Jeremy-Ryan-Mills/hope-project/hope_block_diagram.pdf

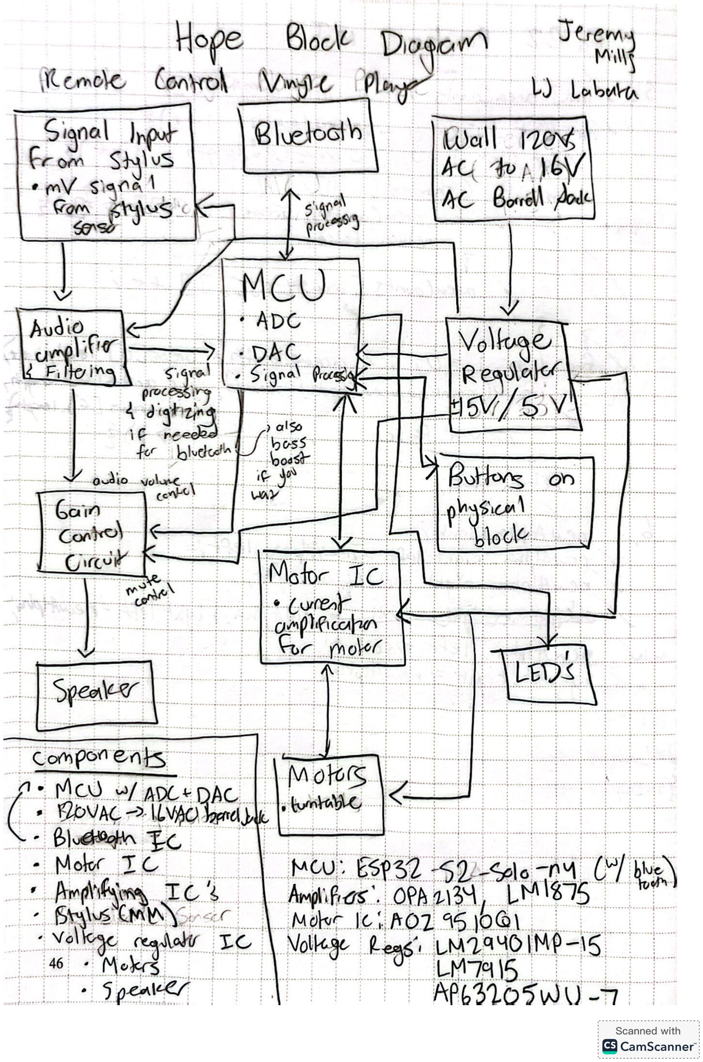
[picture p1: page 1]
