Jeremy-Ryan-Mills/hope-project/61300411121/6130XX11121_61300411121.step

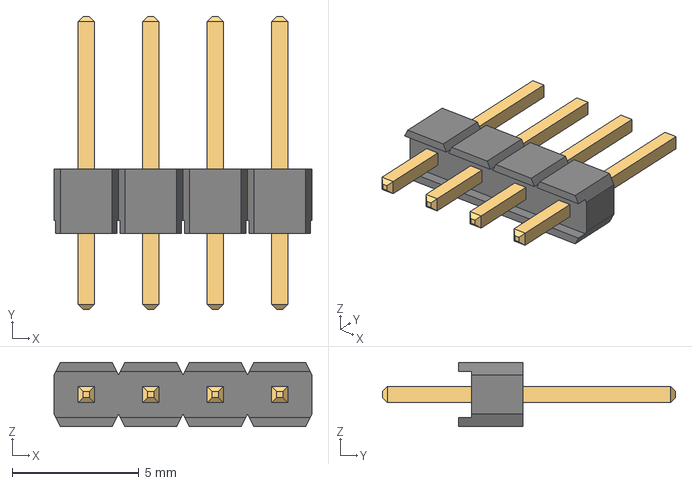
[picture p2: CAD file, 2024-11-08]
61300411121/6130XX11121_61300411121.step
10.2 x 11.5 x 2.54 mm
6130xx11121_PIN x 4
