Jeremy-Ryan-Mills/hope-project/61300511121/6130XX11121_61300511121.step

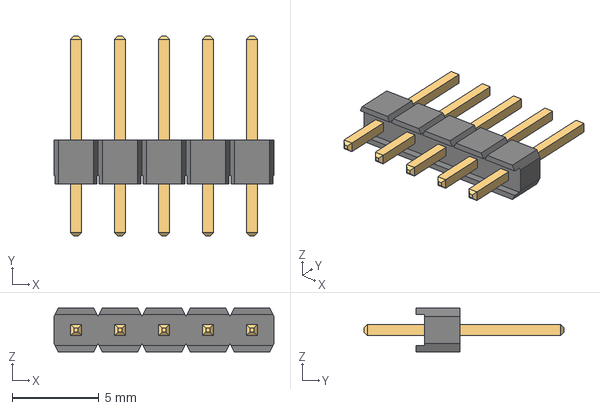
[picture p3: CAD file, 2024-11-08]
61300511121/6130XX11121_61300511121.step
12.7 x 11.5 x 2.54 mm
6130xx11121_PIN x 5
