Jeremy-Ryan-Mills/hope-project/AST_03208MR_R/AST-03208MR-R.step

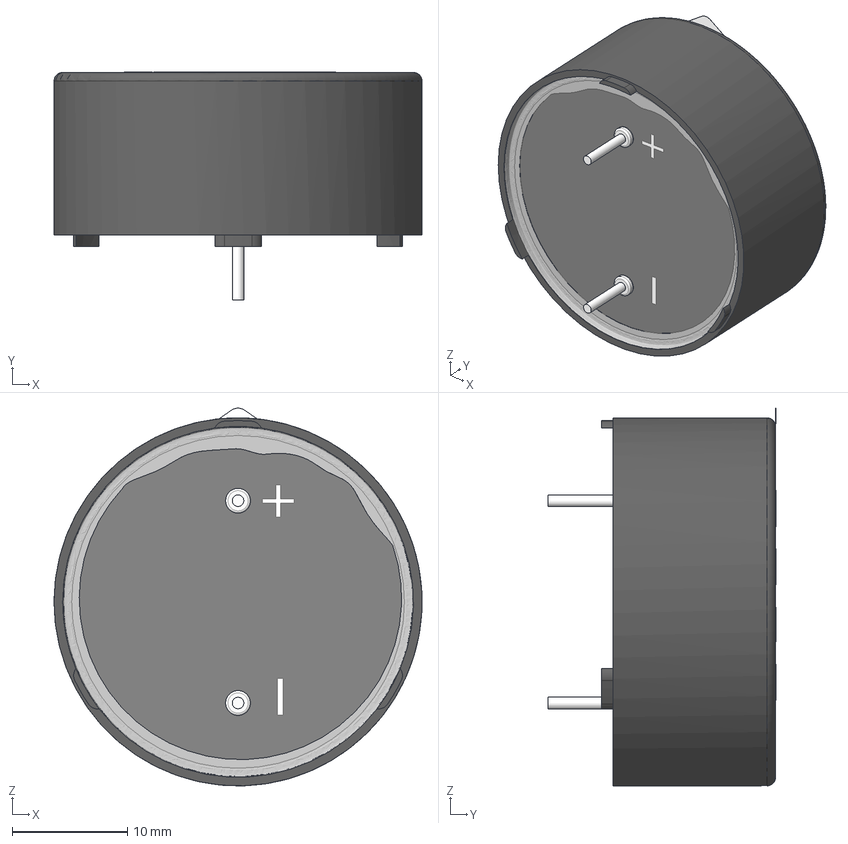
[picture p4: CAD file, 2024-10-26]
AST_03208MR_R/AST-03208MR-R.step
31.9 x 19.7 x 32.7 mm
