Jeremy-Ryan-Mills/hope-project/LT1761ES5_5_TRMPBF/LT1761ES5-5_TRMPBF.step

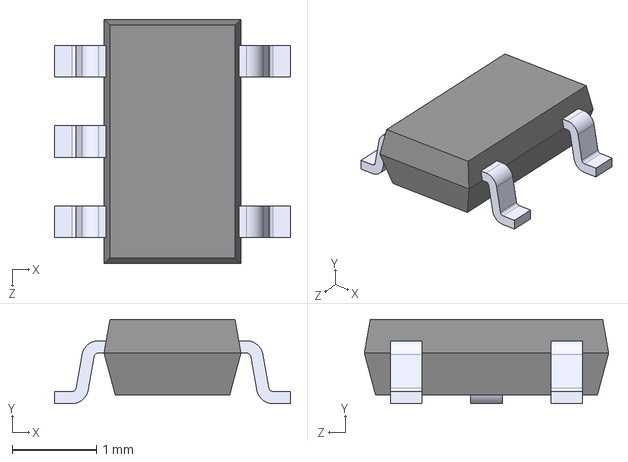
[picture p5: CAD file, 2024-12-07]
LT1761ES5_5_TRMPBF/LT1761ES5-5_TRMPBF.step
2.80 x 1.00 x 2.90 mm
