Jeremy-Ryan-Mills/hope-project/PCM1808PWR/PCM1808PWR.step

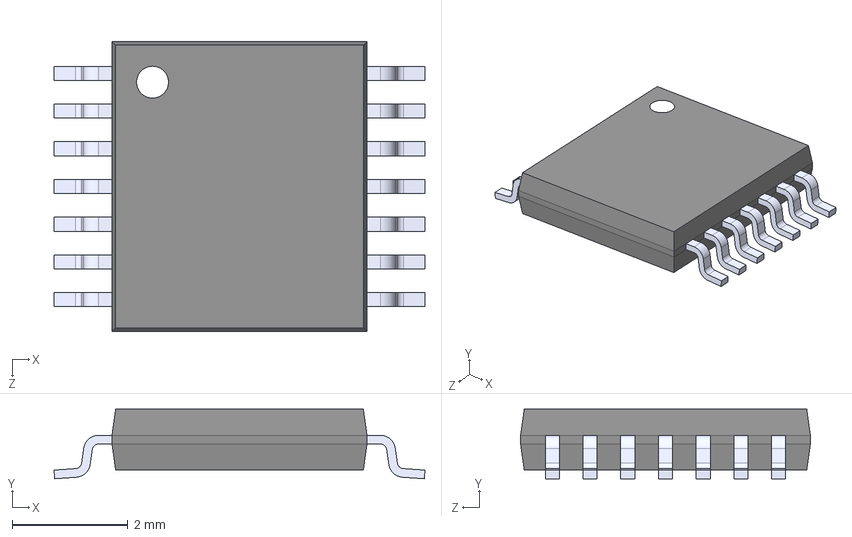
[picture p6: CAD file, 2024-11-08]
PCM1808PWR/PCM1808PWR.step
6.40 x 1.20 x 5.00 mm
