Jeremy-Ryan-Mills/hope-project/PJ_002B/PJ-002B.step

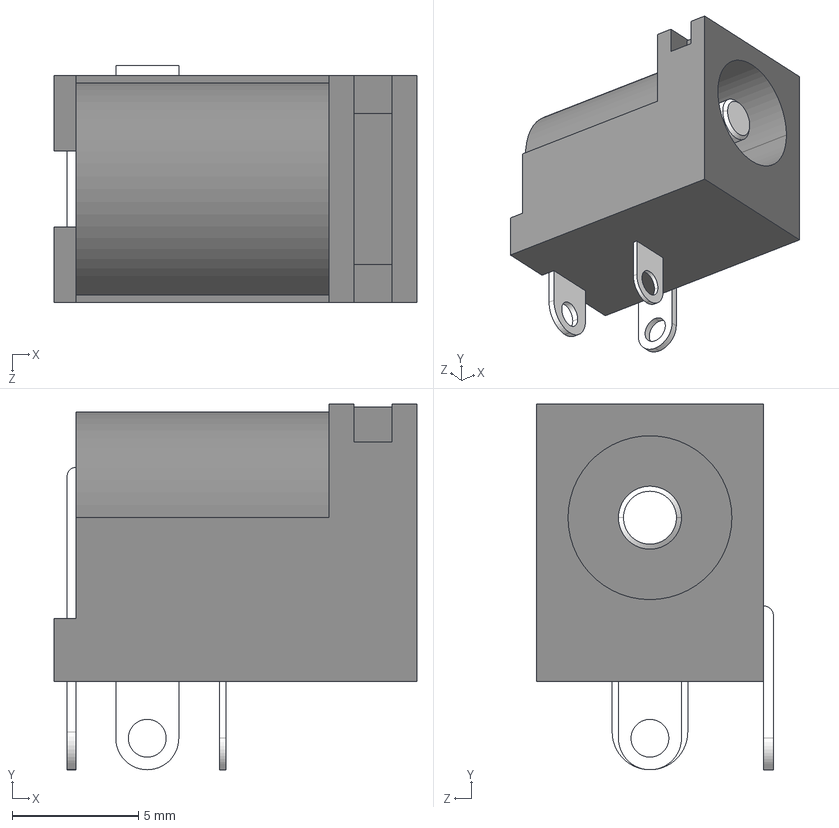
[picture p7: CAD file, 2024-10-26]
PJ_002B/PJ-002B.step
14.4 x 14.5 x 9.40 mm
