Jeremy-Ryan-Mills/hope-project/USB4105_GF_A_120/USB4105GFA120.step

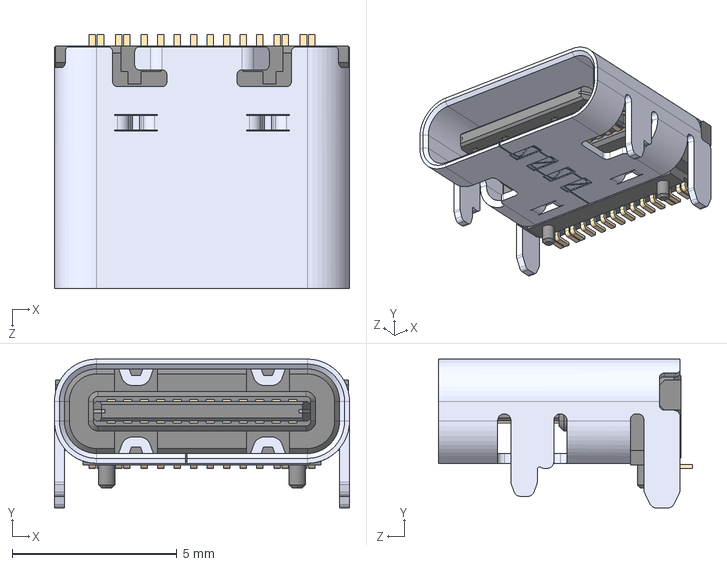
[picture p8: CAD file, 2024-10-31]
USB4105_GF_A_120/USB4105GFA120.step
8.94 x 4.51 x 7.71 mm
