Jeremy-Ryan-Mills/hope-project/schematic_images/hope_final_project.pdf

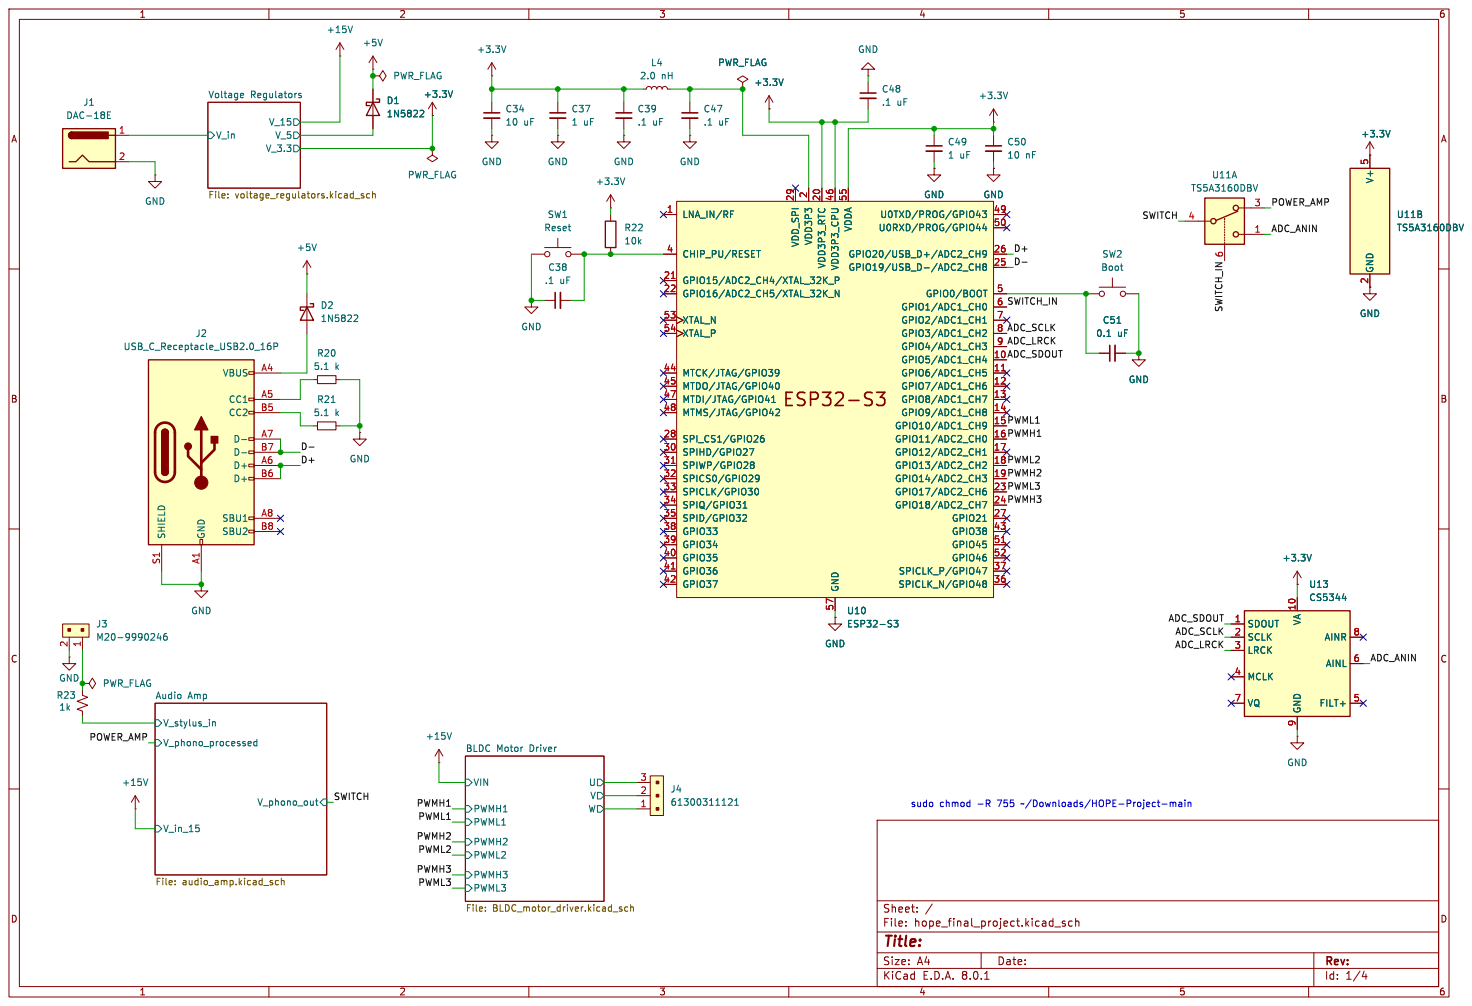
[picture p9: page 1]

2 VDD3P3_RTC 20 GPIO15/ADC2_CH4/XTAL_32K_P 21 GPIO16/ADC2_CH5/XTAL_32K_N 22 GPIO17/ADC2_CH6 23 GPIO18/ADC2_CH7 24 GPIO19/USB_D-/ADC2_CH8 25 GPIO20/USB_D+/ADC2_CH9 26 GPIO21 27 SPI_CS1/GPIO26 28 VDD_SPI 29 SPIHD/GPIO27 30 SPIWP/GPIO28 31 SPICS0/GPIO29 32 SPICLK/GPIO30 33 SPIQ/GPIO31 34 SPID/GPIO32 35 GPIO33 38 GPIO34 39 CHIP_PU/RESET 4 GPIO35 40 GPIO36 41 GPIO37 42 GPIO38 43 MTCK/JTAG/GPIO39 44 MTDO/JTAG/GPIO40 45 VDD3P3_CPU 46 MTDI/JTAG/GPIO41 47 MTMS/JTAG/GPIO42 48 U0TXD/PROG/GPIO43 49 GPIO0/BOOT 5 U0RXD/PROG/GPIO44 50 GPIO45 51 GPIO46 52 XTAL_N 53 XTAL_P 54 VDDA 55 GND 57 GPIO1/ADC1_CH0 6 GPIO2/ADC1_CH1 7 GPIO3/ADC1_CH2 8 GPIO4/ADC1_CH3 9 D1

2 VDD3P3_RTC 20 GPIO15/ADC2_CH4/XTAL_32K_P 21 GPIO16/ADC2_CH5/XTAL_32K_N 22 GPIO17/ADC2_CH6 23 GPIO18/ADC2_CH7 24 GPIO19/USB_D-/ADC2_CH8 25 GPIO20/USB_D+/ADC2_CH9 26 GPIO21 27 SPI_CS1/GPIO26 28 VDD_SPI 29 SPIHD/GPIO27 30 SPIWP/GPIO28 31 SPICS0/GPIO29 32 SPICLK/GPIO30 33 SPIQ/GPIO31 34 SPID/GPIO32 35 GPIO33 38 GPIO34 39 CHIP_PU/RESET 4 GPIO35 40 GPIO36 41 GPIO37 42 GPIO38 43 MTCK/JTAG/GPIO39 44 MTDO/JTAG/GPIO40 45 VDD3P3_CPU 46 MTDI/JTAG/GPIO41 47 MTMS/JTAG/GPIO42 48 U0TXD/PROG/GPIO43 49 GPIO0/BOOT 5 U0RXD/PROG/GPIO44 50 GPIO45 51 GPIO46 52 XTAL_N 53 XTAL_P 54 VDDA 55 GND 57 GPIO1/ADC1_CH0 6 GPIO2/ADC1_CH1 7 GPIO3/ADC1_CH2 8 GPIO4/ADC1_CH3 9 U10 ESP32-S3 GND A1 VBUS A4 CC1 A5 D+ A6 D- A7 SBU1 A8 CC2 B5 D+ B6 D- B7 SBU2 B8 SHIELD S1

BLDC Motor Driver File: BLDC_motor_driver.kicad_sch V_phono_out

Id: 1/4 Title: File: hope_final_project.kicad_sch Sheet: /

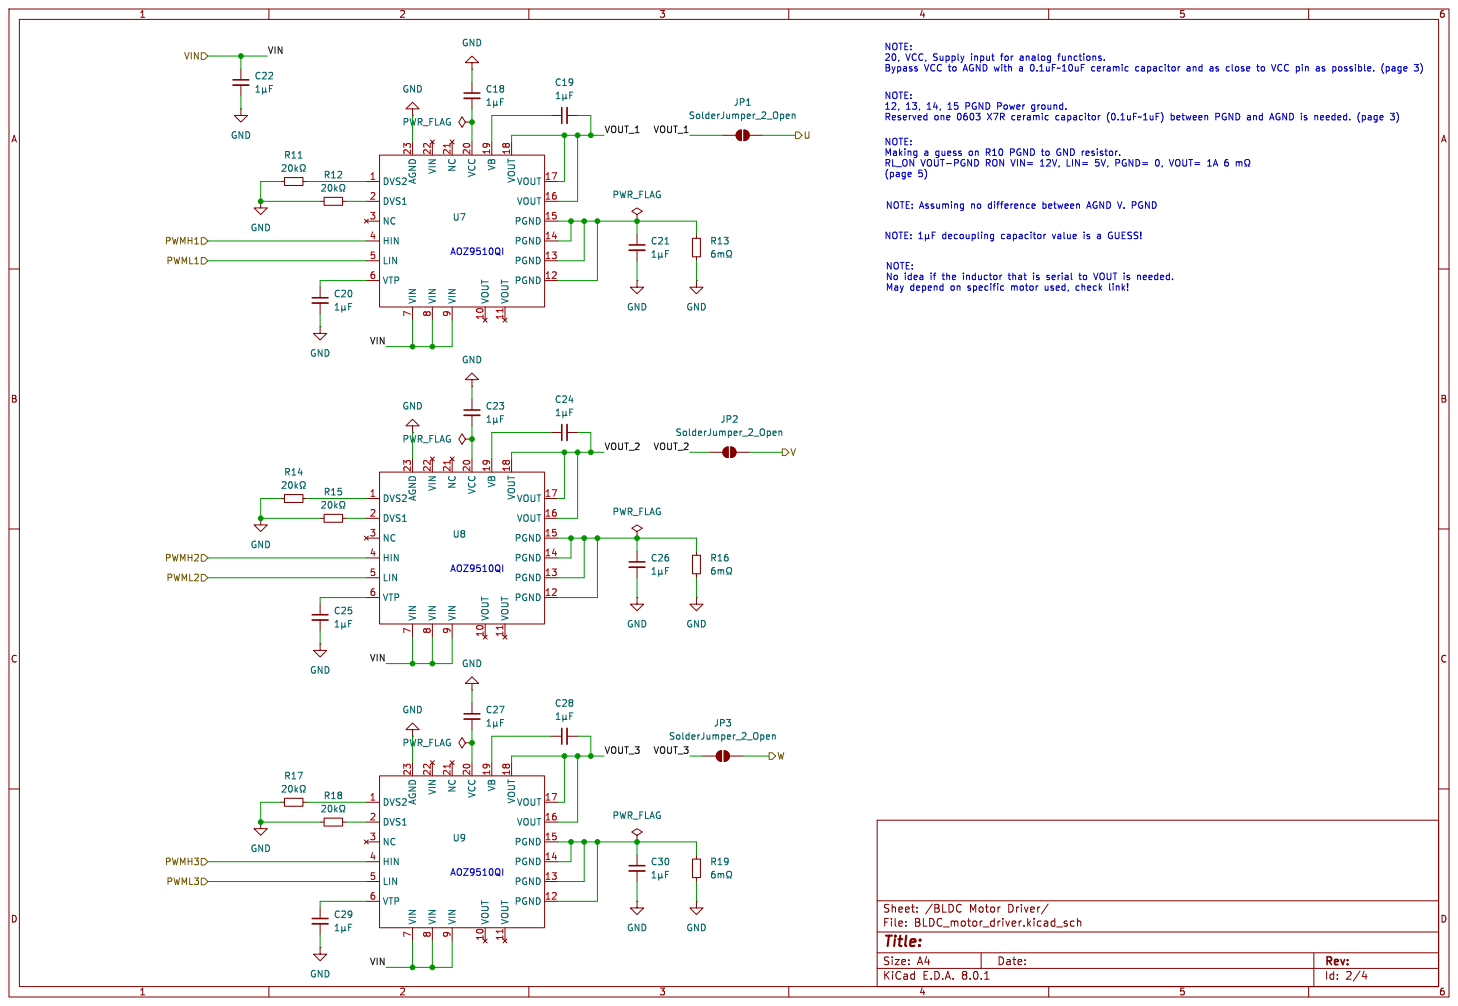
[picture p10: page 2]

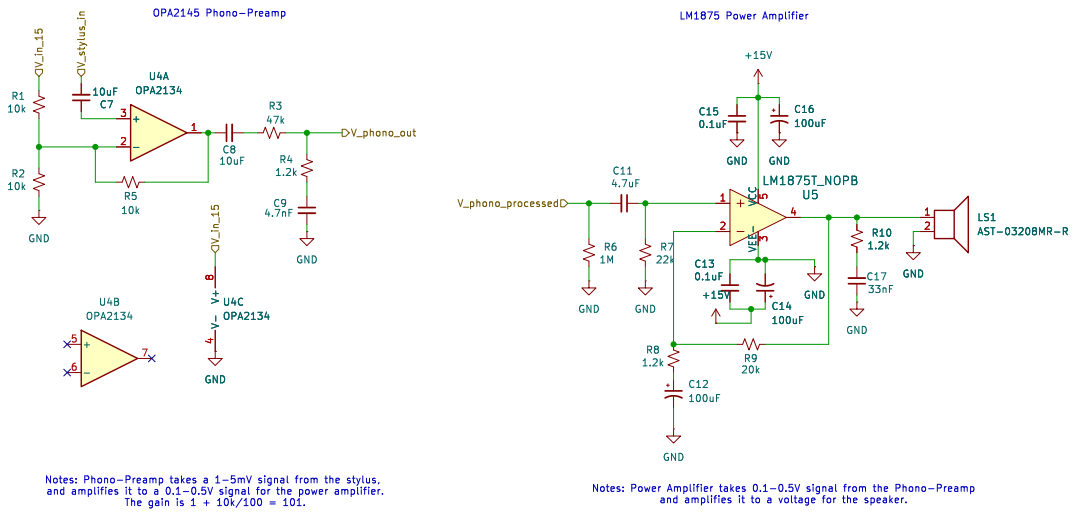
[picture p11: page 3]

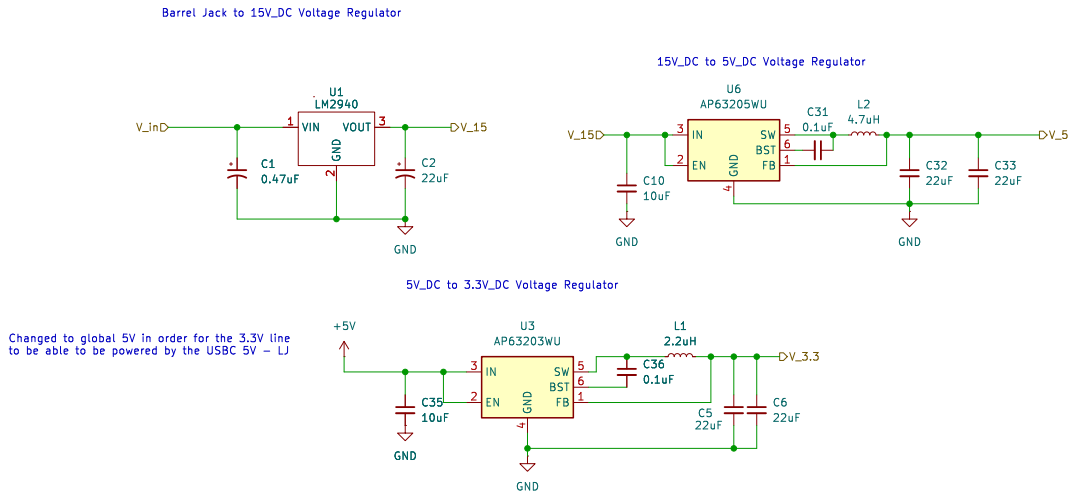
[picture p12: page 4]

Changed to global 5V in order for the 3.3V line
