Jeremy-Ryan-Mills/hope-project/recordplayer_hope_final_project_bom.pdf

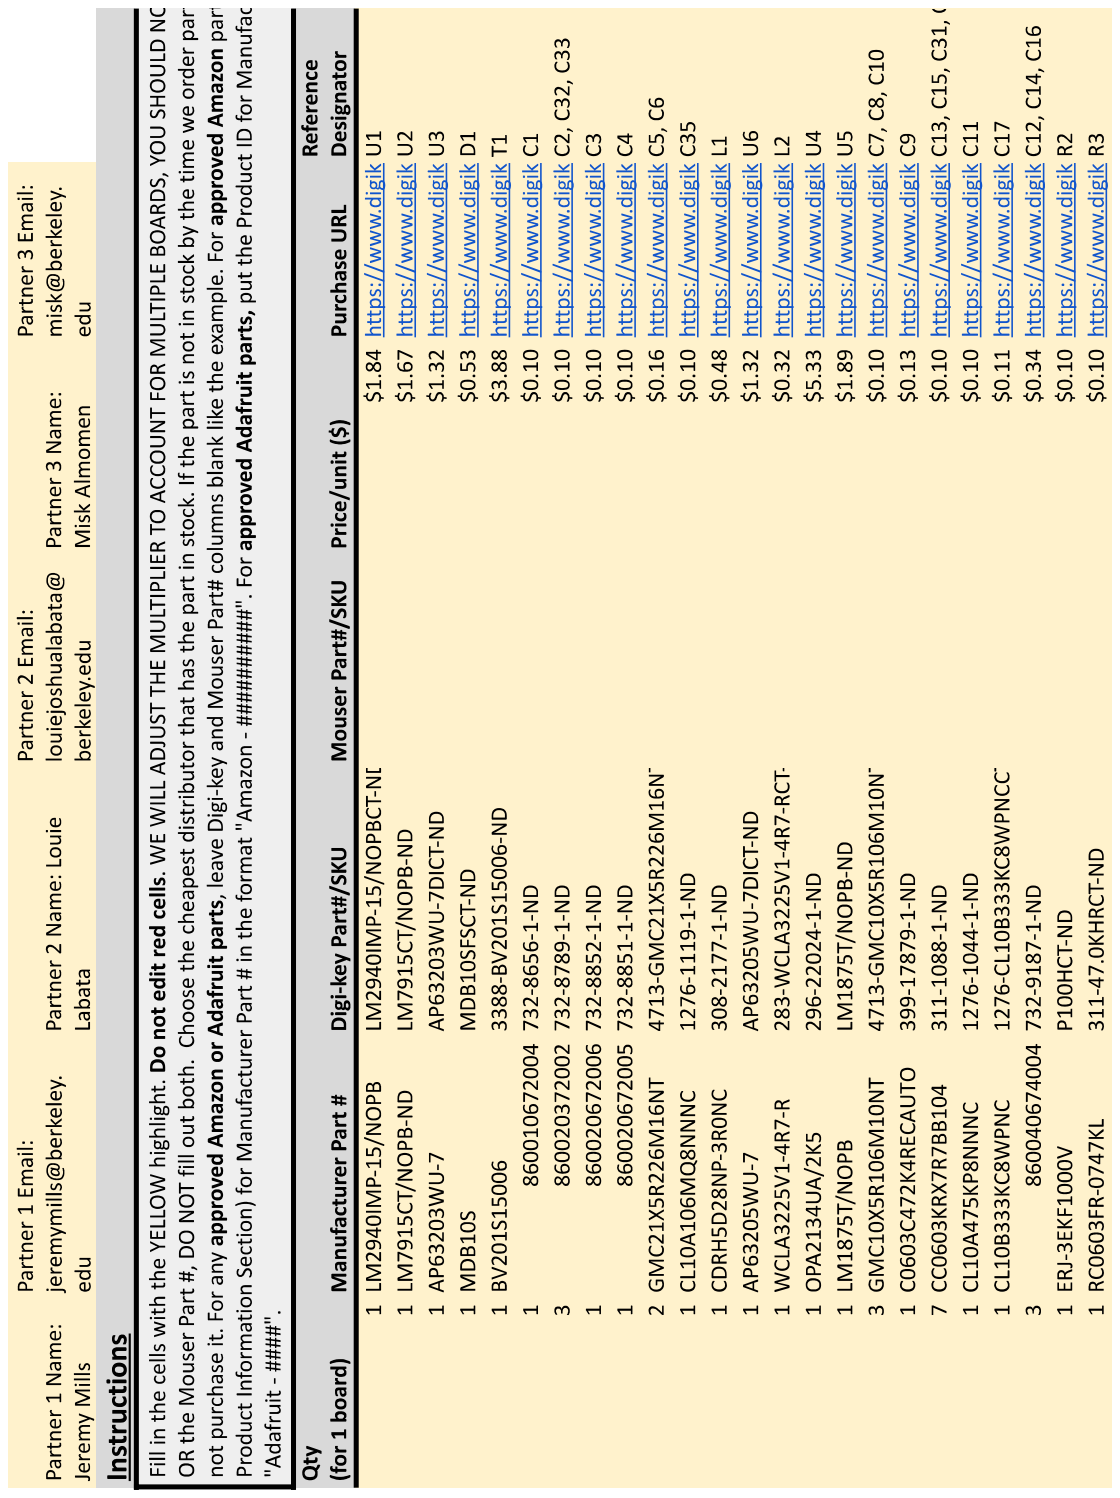
[picture p13: page 1]

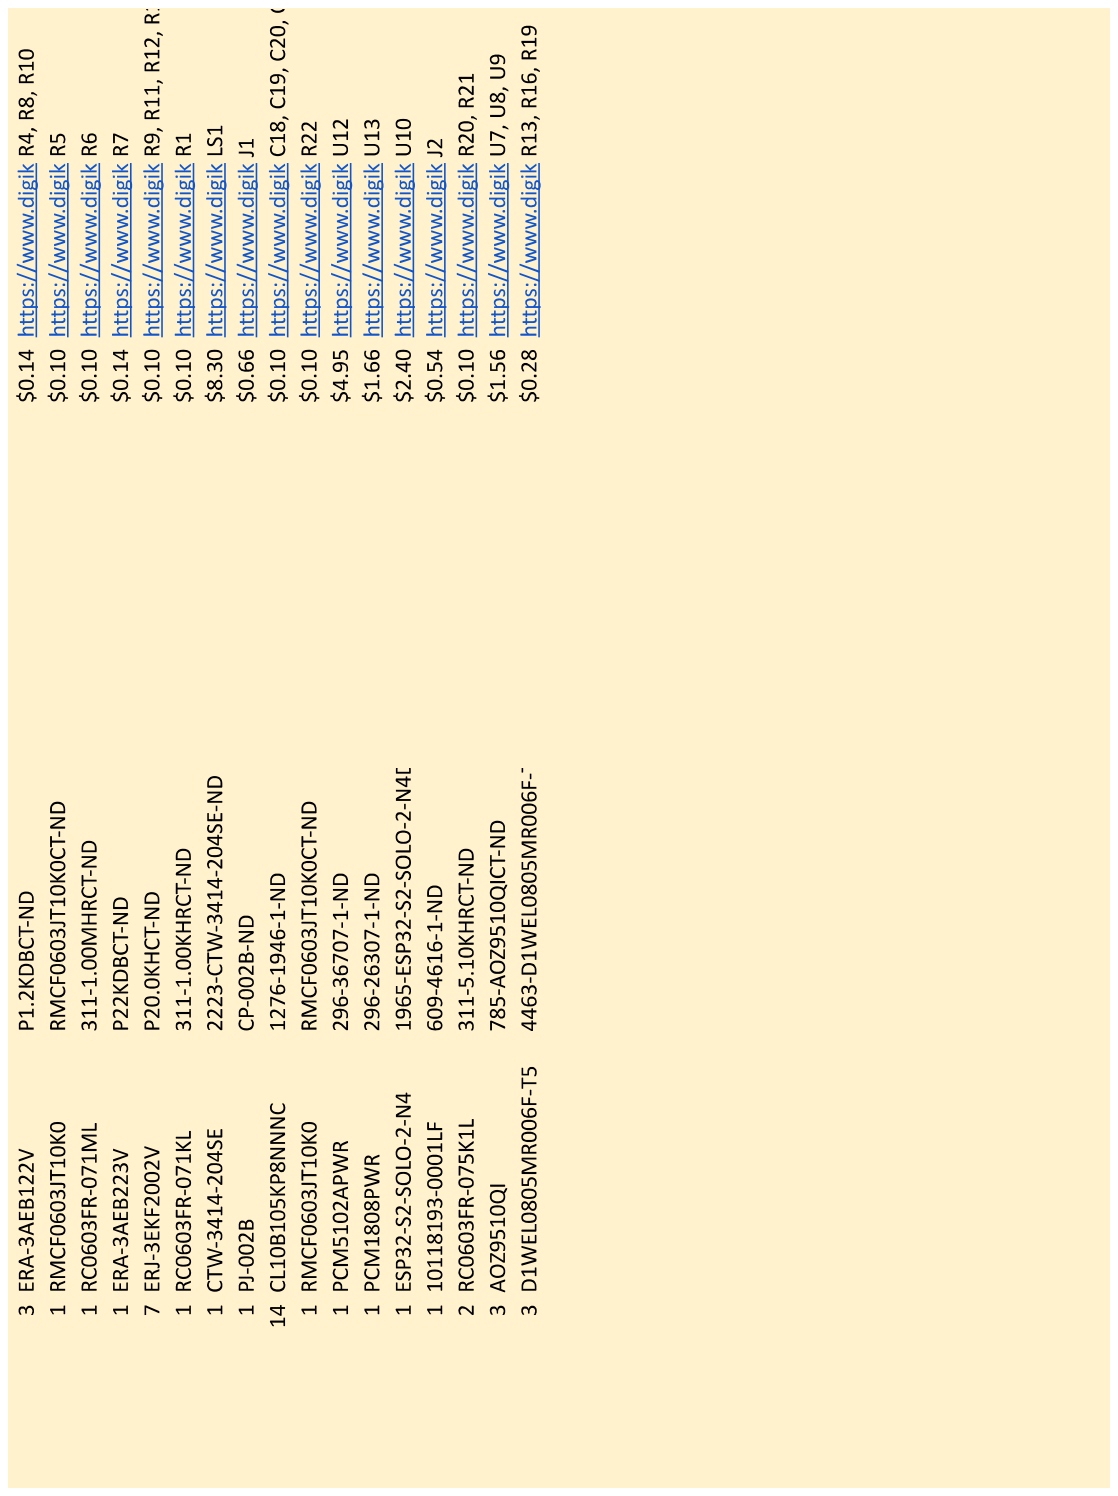
[picture p14: page 2]
