Jeremy-Ryan-Mills/hope-project/hope_final_project.kicad_pcb

## KiCad design hope_final_project.kicad_pcb (2024-12-07)

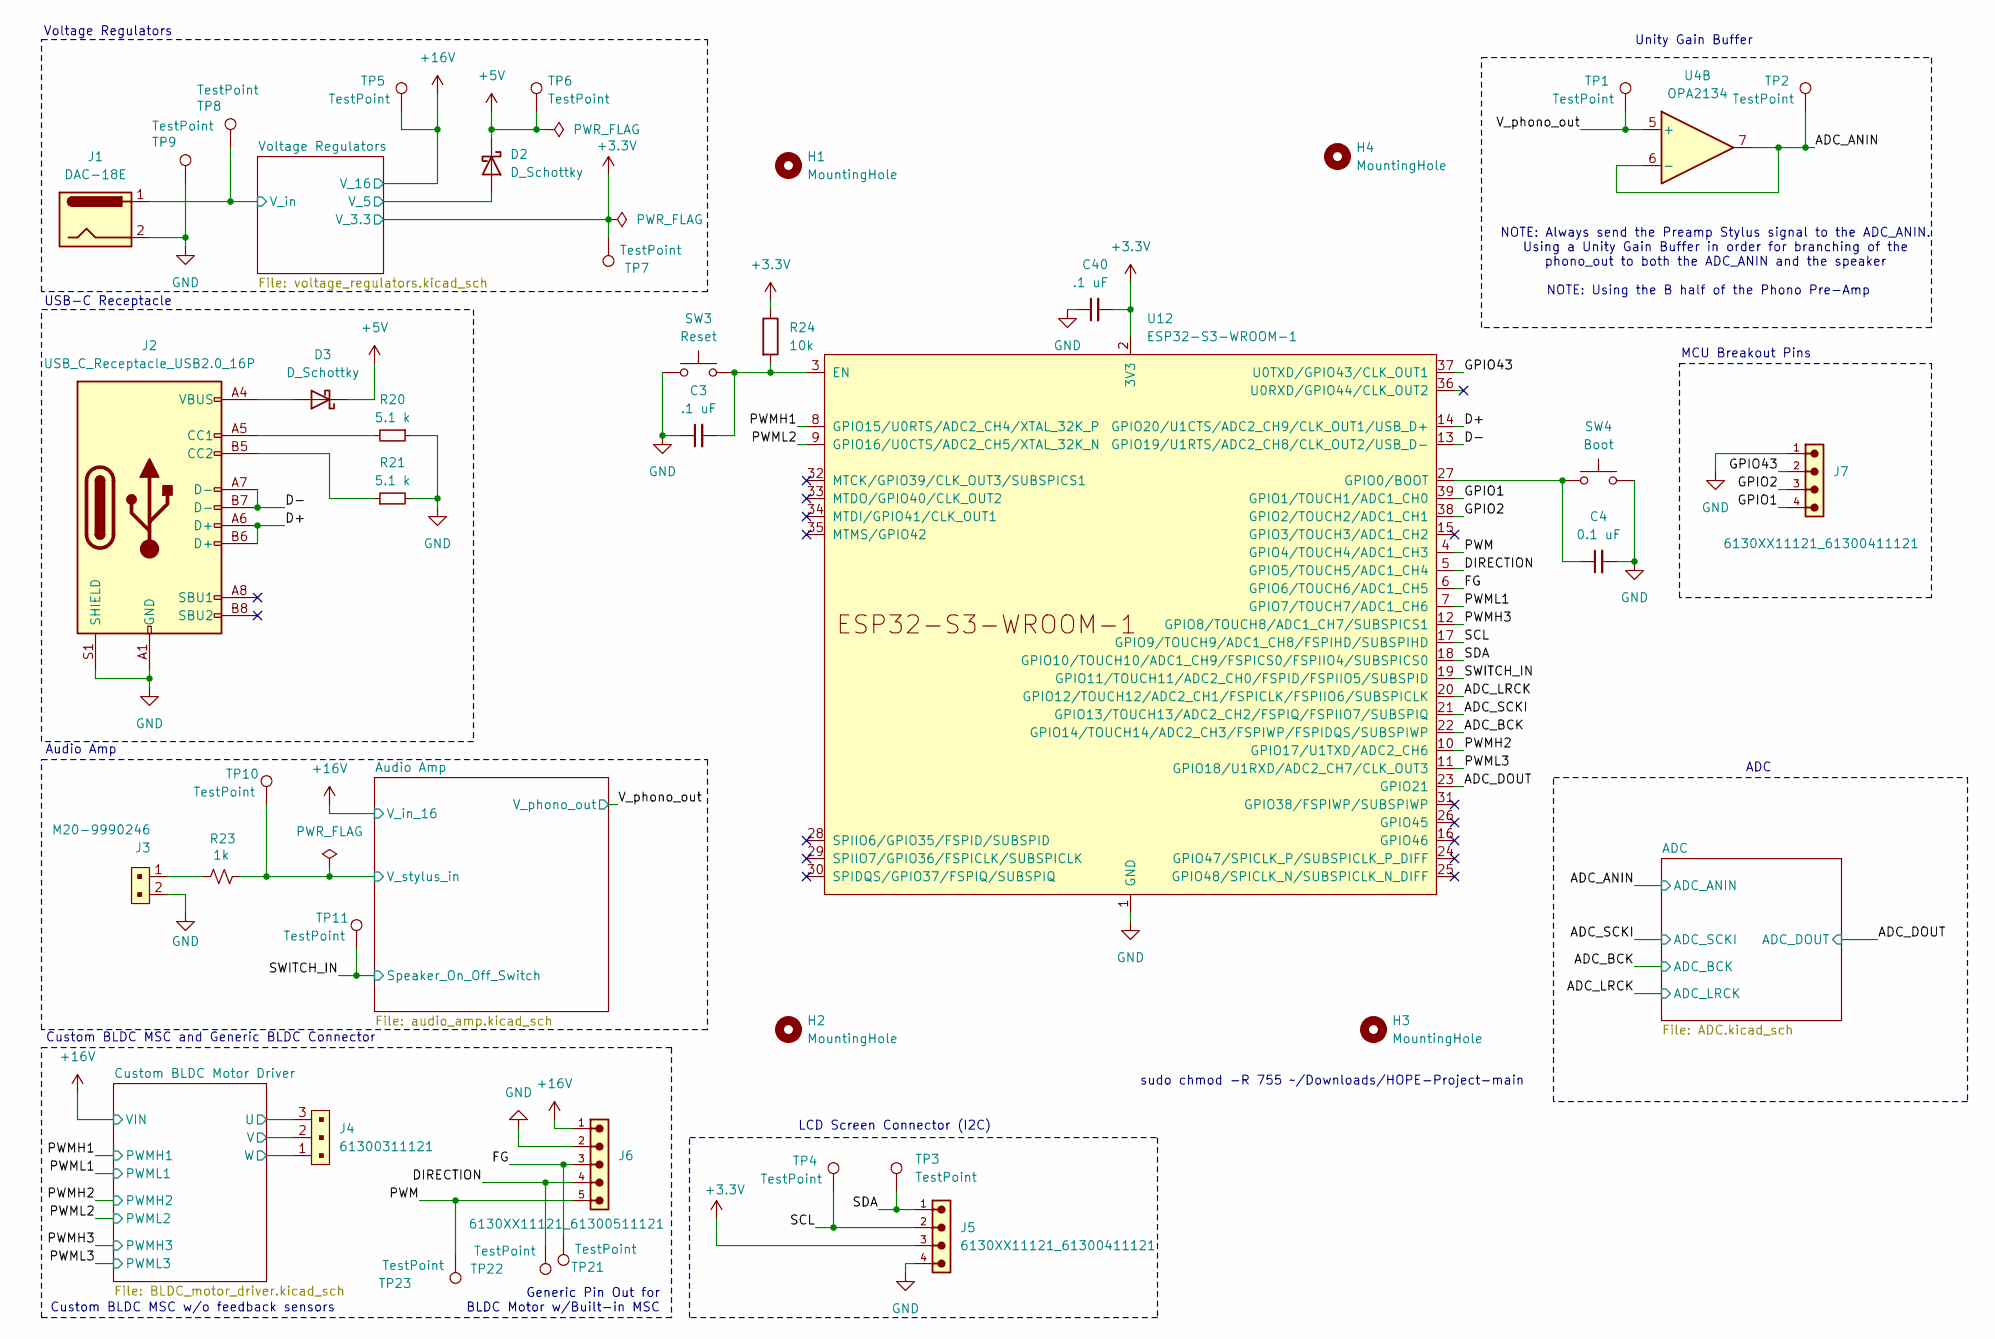
[picture p15: schematic hope_final_project.kicad_sch]

Parts:
C3, C40: .1 uF; C_0805_2012Metric
C4: 0.1 uF; C_0805_2012Metric
D2, D3: D_Schottky; D_SOD-123F
H1, H2, H3, H4: MountingHole; MountingHole_3.2mm_M3
J1: DAC-18E; PJ_002B
J2: USB_C_Receptacle_USB2.0_16P; GCT_USB4105GFA120
J3: M20-9990246; PinHeader_1x2_P2.54mm; MPN M20-9990246; Digi-Key_PN 952-2262-ND
J4: 61300311121; PinHeader_1x3_P2.54_Drill1.1mm; MPN 61300311121; Digi-Key_PN 732-5316-ND
J5, J7: 6130XX11121_61300411121; 61300411121; PART-NUMBER 61300411121
J6: 6130XX11121_61300511121; 61300511121; PART-NUMBER 61300511121
R20, R21: 5.1 k; R_0805_2012Metric
R23: 1k; R_0805_2012Metric
R24: 10k; R_0805_2012Metric
SW3: Reset; TL3301_A_G_EWI
SW4: Boot; TL3301_A_G_EWI
TP1, TP2, TP3, TP4, TP5, TP6, TP7, TP8, TP9, TP10, TP11, TP21, TP22, TP23: TestPoint; TestPoint_Pad_1.5x1.5mm
U4: OPA2134; SOIC-8_W3.9mm
U12: ESP32-S3-WROOM-1

Connections:
+3.3V: C40.2, J5.3, R24.1, TP7.1, U12.2 (3V3); also elsewhere on the board
+5V: D2.1 (K), D3.1 (K), TP6.1; also elsewhere on the board
+16V: J6.1, TP5.1; also elsewhere on the board
/ADC_ANIN: TP2.1, U4.6 (-), U4.7; also elsewhere on the board
/ADC_BCK: U12.22 (GPIO14/TOUCH14/ADC2_CH3/FSPIWP/FSPIDQS/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); also elsewhere on the board
/ADC_DOUT: U12.23 (GPIO21); also elsewhere on the board
/ADC_LRCK: U12.20 (GPIO12/TOUCH12/ADC2_CH1/FSPICLK/FSPIIO6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); also elsewhere on the board
/ADC_SCKI: U12.21 (GPIO13/TOUCH13/ADC2_CH2/FSPIQ/FSPIIO7/S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); also elsewhere on the board
/Audio Amp/V_stylus_in: R23.1, TP10.1; also elsewhere on the board
/Custom BLDC Motor Driver/VOUT_1: J4.3; also elsewhere on the board
/Custom BLDC Motor Driver/VOUT_2: J4.2; also elsewhere on the board
/Custom BLDC Motor Driver/VOUT_3: J4.1; also elsewhere on the board
/D+: J2.A6 (D+), J2.B6 (D+), U12.14 (GPIO20/U1CTS/ADC2_CH9/CLK_OUT1/USB_D+)
/D-: J2.A7 (D-), J2.B7 (D-), U12.13 (GPIO19/U1RTS/ADC2_CH8/CLK_OUT2/USB_D-)
/DIRECTION: J6.4, TP22.1, U12.5 (GPIO5/TOUCH5/ADC1_CH4)
/FG: J6.3, TP21.1, U12.6 (GPIO6/TOUCH6/ADC1_CH5)
/GPIO1: J7.4, U12.39 (GPIO1/TOUCH1/ADC1_CH0)
/GPIO2: J7.3, U12.38 (GPIO2/TOUCH2/ADC1_CH1)
/GPIO43: J7.2, U12.37 (U0TXD/GPIO43/CLK_OUT1)
/PWM: J6.5, TP23.1, U12.4 (GPIO4/TOUCH4/ADC1_CH3)
/PWMH1: U12.8 (GPIO15/U0RTS/ADC2_CH4/XTAL_32K_P); also elsewhere on the board
/PWMH2: U12.10 (GPIO17/U1TXD/ADC2_CH6); also elsewhere on the board
/PWMH3: U12.12 (GPIO8/TOUCH8/ADC1_CH7/SUBSPICS1); also elsewhere on the board
/PWML1: U12.7 (GPIO7/TOUCH7/ADC1_CH6); also elsewhere on the board
/PWML2: U12.9 (GPIO16/U0CTS/ADC2_CH5/XTAL_32K_N); also elsewhere on the board
/PWML3: U12.11 (GPIO18/U1RXD/ADC2_CH7/CLK_OUT3); also elsewhere on the board
/SCL: J5.2, TP4.1, U12.17 (GPIO9/TOUCH9/ADC1_CH8/FSPIHD/SUBSPIHD)
/SDA: J5.1, TP3.1, U12.18 (GPIO10/TOUCH10/ADC1_CH9/FSPICS0/FSPIIO4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)
/SWITCH_IN: TP11.1, U12.19 (GPIO11/TOUCH11/ADC2_CH0/FSPID/FSPIIO5/S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); also elsewhere on the board
/V_phono_out: TP1.1, U4.5 (+); also elsewhere on the board
/Voltage Regulators/V_5: D2.2 (A); also elsewhere on the board
/Voltage Regulators/V_in: J1.1, TP8.1; also elsewhere on the board
GND: C3.1, C4.2, C40.1, J1.2, J2.A1 (GND), J2.A12 (GND), J2.B1 (GND), J2.B12 (GND), J2.S1 (SHIELD), J3.2, J5.4, J6.2, J7.1, R20.1, R21.2, SW3.1 (A), SW3.2 (A), SW4.3 (B), SW4.4 (B), TP9.1, U12.1 (GND), U12.40 (GND), U12.41 (GND); also elsewhere on the board
unnamed: D3.2 (A), J2.A4 (VBUS), J2.A9 (VBUS), J2.B4 (VBUS), J2.B9 (VBUS)
unnamed: J2.A5 (CC1), R20.2
unnamed: J2.B5 (CC2), R21.1
unnamed: J3.1, R23.2
unnamed: C3.2, R24.2, SW3.3 (B), SW3.4 (B), U12.3 (EN)
unnamed: C4.1, SW4.1 (A), SW4.2 (A), U12.27 (GPIO0/BOOT)

Notes on the sheet:
Custom BLDC MSC w/o feedback sensors
Audio Amp
Unity Gain Buffer
MCU Breakout Pins
NOTE: Using the B half of the Phono Pre-Amp
USB-C Receptacle
LCD Screen Connector (I2C)
Custom BLDC MSC and Generic BLDC Connector
Generic Pin Out for BLDC Motor w/Built-in MSC
ADC
Voltage Regulators
NOTE: Always send the Preamp Stylus signal to the ADC_ANIN. Using a Unity Gain Buffer in order for branching of the phono_out to both the ADC_ANIN and the speaker
sudo chmod -R 755 ~/Downloads/HOPE-Project-main

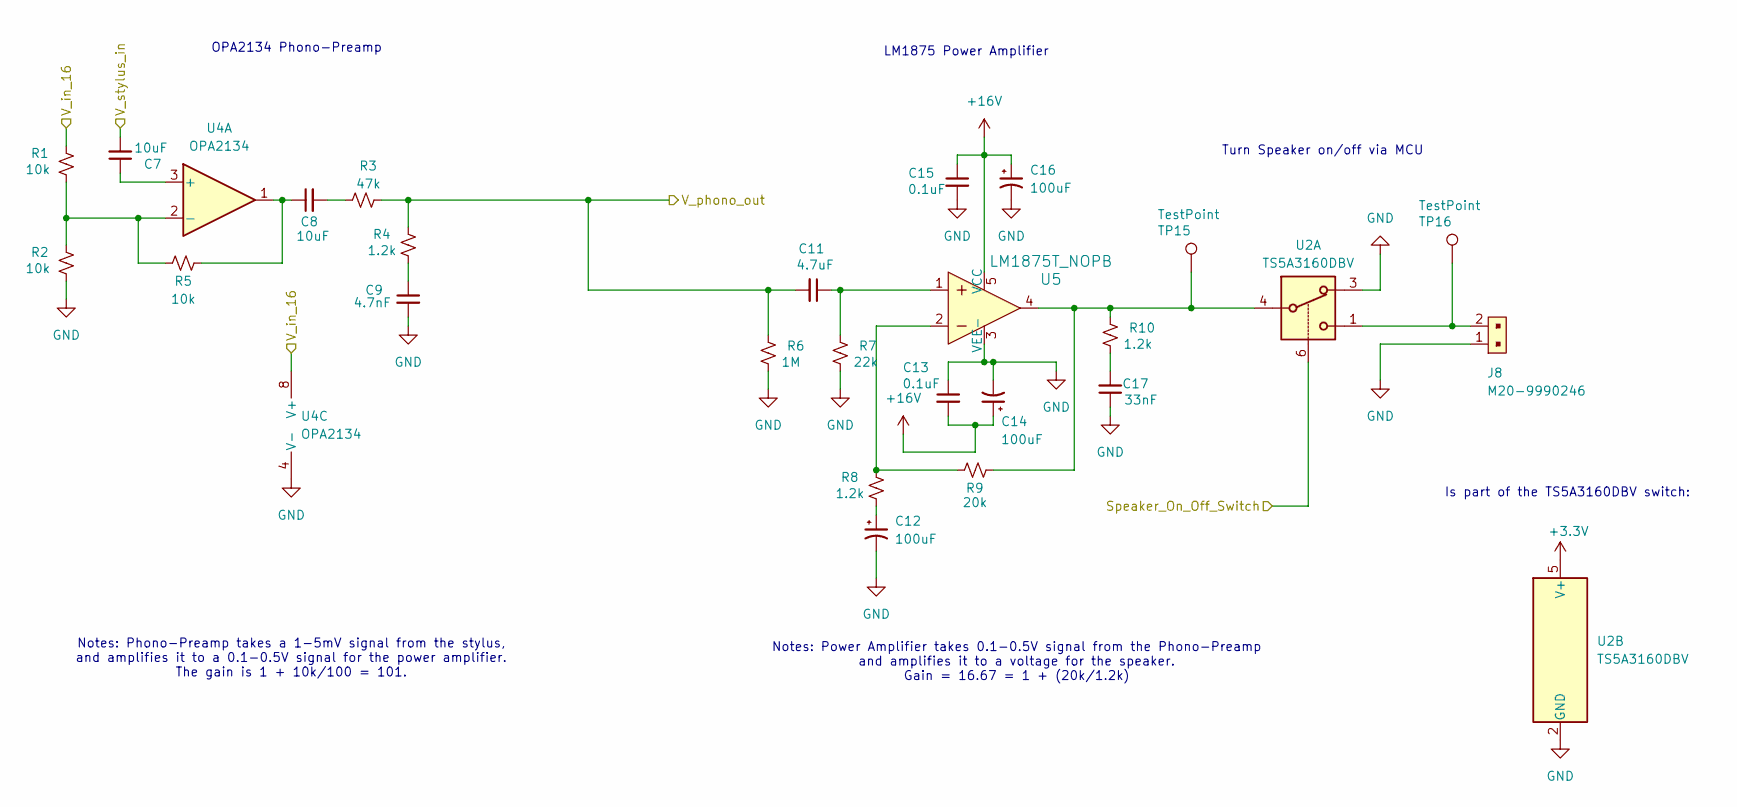
[picture p16: schematic audio_amp.kicad_sch]

Parts:
C7, C8: 10uF; C_0805_2012Metric
C9: 4.7nF; C_0805_2012Metric
C11: 4.7uF; C_0805_2012Metric
C12, C14, C16: 100uF; C_Radial_D8.0mm_H11.5mm_P3.50mm
C13, C15: 0.1uF; C_0805_2012Metric
C17: 33nF; C_0805_2012Metric
J8: M20-9990246; PinHeader_1x2_P2.54mm; MPN M20-9990246; Digi-Key_PN 952-2262-ND
R1, R2, R5: 10k; R_0805_2012Metric
R3: 47k; R_0805_2012Metric
R4, R8, R10: 1.2k; R_0805_2012Metric
R6: 1M; R_0805_2012Metric
R7: 22k; R_0805_2012Metric
R9: 20k; R_0805_2012Metric
TP15, TP16: TestPoint; TestPoint_Pad_1.5x1.5mm
U2: TS5A3160DBV; SOT-23-6
U4: OPA2134; SOIC-8_W3.9mm
U5: LM1875T_NOPB; TO-220-5; MPN LM1875T/NOPB; Digi-Key_PN LM1875T/NOPB-ND

Connections:
+3.3V: U2.5 (V+); also elsewhere on the board
+16V: C13.2, C14.1, C15.1, C16.1, R1.1, U4.8 (V+), U5.5 (VCC); also elsewhere on the board
/Audio Amp/V_stylus_in: C7.2; also elsewhere on the board
/SWITCH_IN: U2.6; also elsewhere on the board
/V_phono_out: C11.2, R3.2, R4.1, R6.1; also elsewhere on the board
GND: C9.2, C12.2, C13.1, C14.2, C15.2, C16.2, C17.1, J8.1, R2.2, R6.2, R7.2, U2.2 (GND), U2.3, U4.4 (V-), U5.3 (VEE-); also elsewhere on the board
unnamed: C8.1, R5.2, U4.1
unnamed: C8.2, R3.1
unnamed: C9.1, R4.2
unnamed: C11.1, R7.1, U5.1
unnamed: C12.1, R8.2
unnamed: C17.2, R10.2
unnamed: J8.2, TP16.1, U2.1
unnamed: R8.1, R9.1, U5.2
unnamed: R9.2, R10.1, TP15.1, U2.4, U5.4
unnamed: C7.1, U4.3 (+)
unnamed: R1.2, R2.1, R5.1, U4.2 (-)

Notes on the sheet:
OPA2134 Phono-Preamp
Is part of the TS5A3160DBV switch:
LM1875 Power Amplifier
Notes: Phono-Preamp takes a 1-5mV signal from the stylus, and amplifies it to a 0.1-0.5V signal for the power amplifier. The gain is 1 + 10k/100 = 101.
Notes: Power Amplifier takes 0.1-0.5V signal from the Phono-Preamp and amplifies it to a voltage for the speaker. Gain = 16.67 = 1 + (20k/1.2k)
Turn Speaker on/off via MCU

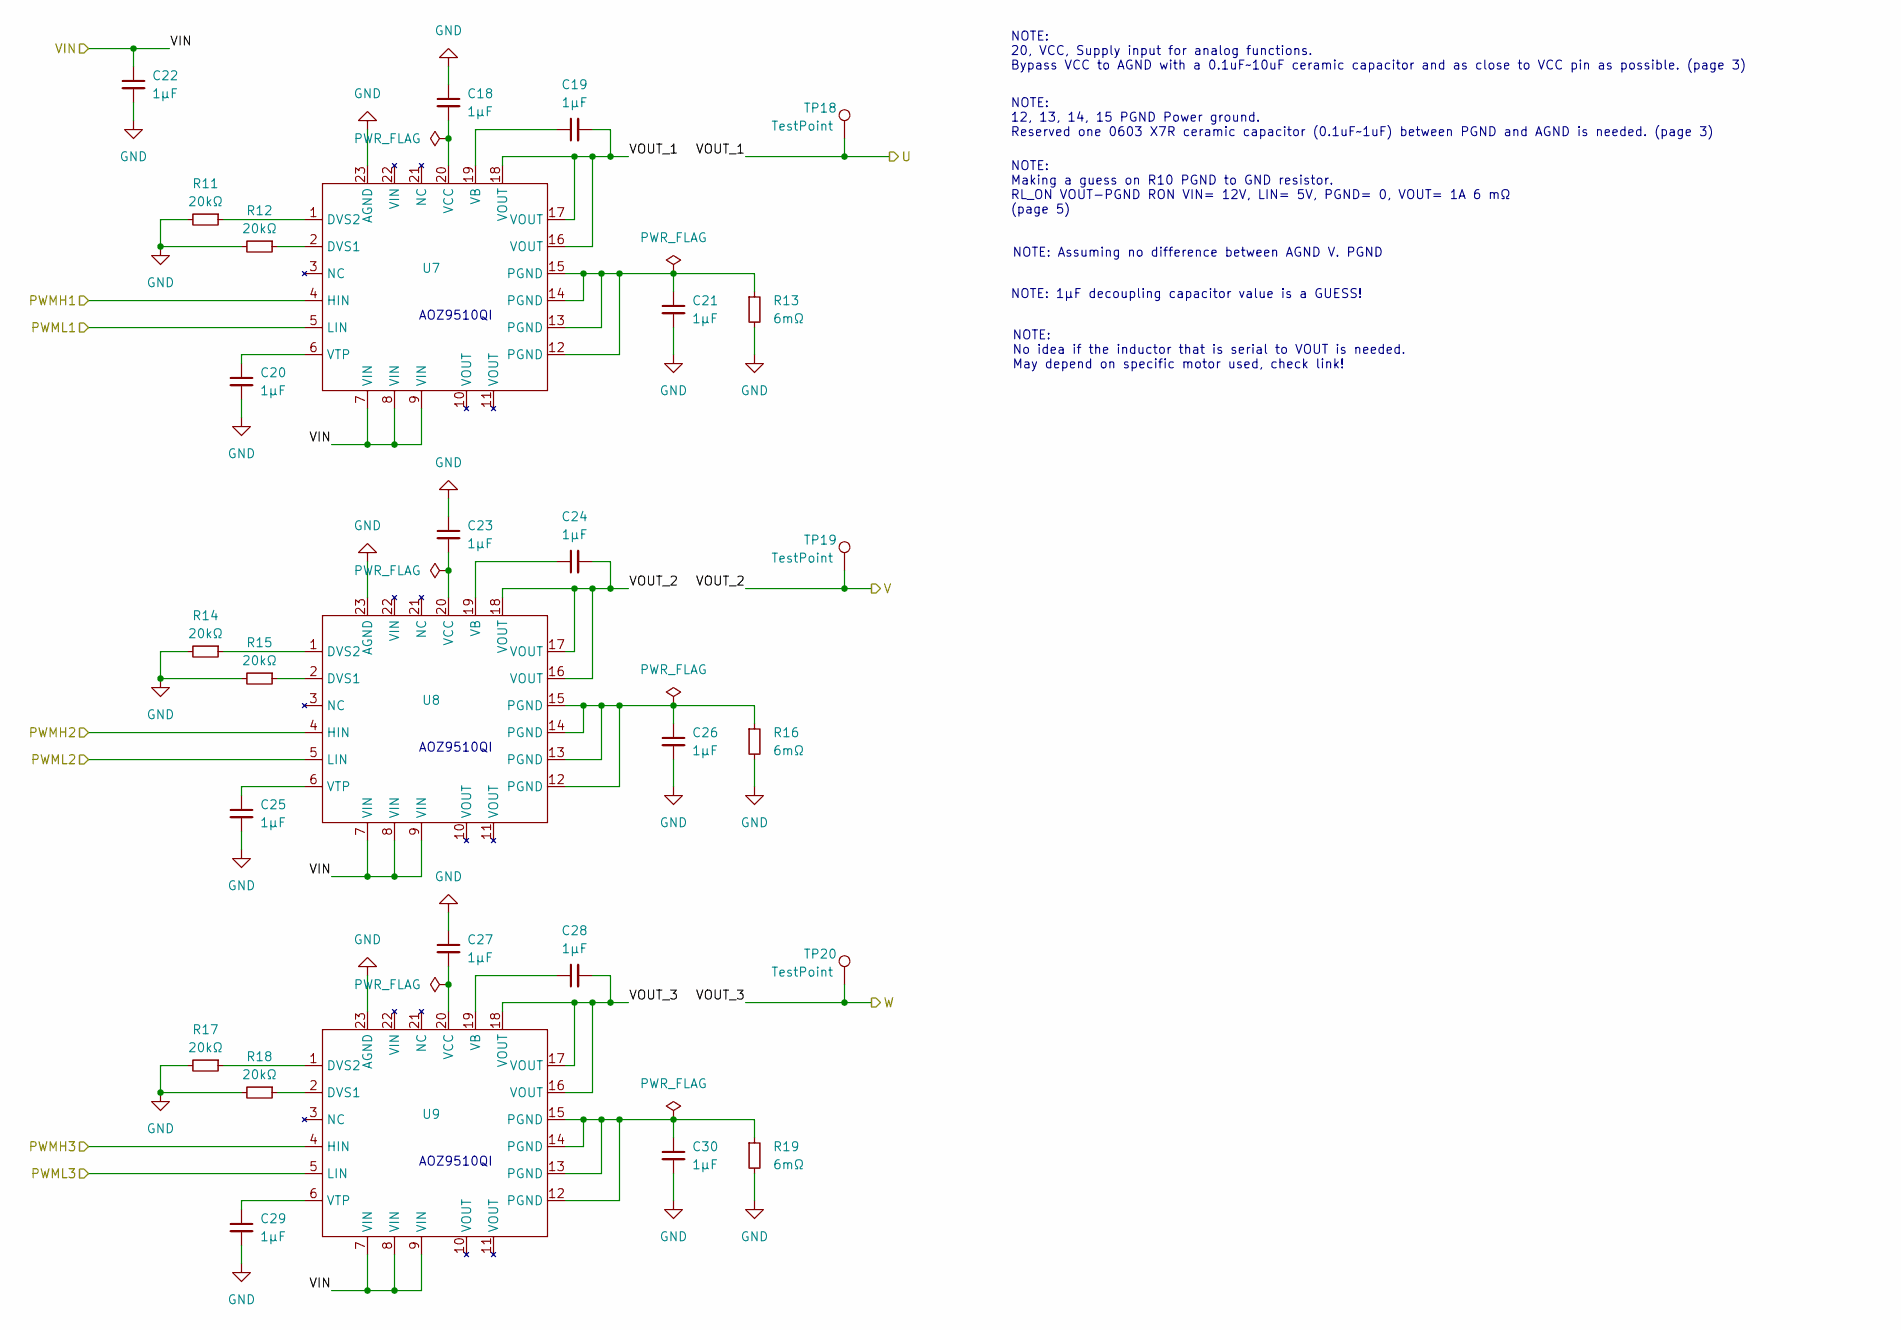
[picture p17: schematic BLDC_motor_driver.kicad_sch]

Parts:
C18, C19, C20, C21, C22, C23, C24, C25, C26, C27, C28, C29, C30: 1µF; C_0805_2012Metric
R11, R12, R14, R15, R17, R18: 20kΩ; R_0805_2012Metric
R13, R16, R19: 6mΩ; R_0805_2012Metric
TP18, TP19, TP20: TestPoint; TestPoint_Pad_1.5x1.5mm
U7, U8, U9: QFN-24-1EP_4x4mm_P0.5mm_EP2.7x2.7mm

Connections:
+16V: C22.1, U7.7 (VIN), U7.8 (VIN), U7.9 (VIN), U8.7 (VIN), U8.8 (VIN), U8.9 (VIN), U9.7 (VIN), U9.8 (VIN), U9.9 (VIN); also elsewhere on the board
/Custom BLDC Motor Driver/VOUT_1: C19.2, TP18.1, U7.16 (VOUT), U7.17 (VOUT), U7.18 (VOUT); also elsewhere on the board
/Custom BLDC Motor Driver/VOUT_2: C24.2, TP19.1, U8.16 (VOUT), U8.17 (VOUT), U8.18 (VOUT); also elsewhere on the board
/Custom BLDC Motor Driver/VOUT_3: C28.2, TP20.1, U9.16 (VOUT), U9.17 (VOUT), U9.18 (VOUT); also elsewhere on the board
/PWMH1: U7.4 (HIN); also elsewhere on the board
/PWMH2: U8.4 (HIN); also elsewhere on the board
/PWMH3: U9.4 (HIN); also elsewhere on the board
/PWML1: U7.5 (LIN); also elsewhere on the board
/PWML2: U8.5 (LIN); also elsewhere on the board
/PWML3: U9.5 (LIN); also elsewhere on the board
GND: C18.1, C20.2, C21.2, C22.2, C23.1, C25.2, C26.2, C27.1, C29.2, C30.2, R11.2, R12.2, R13.2, R14.2, R15.2, R16.2, R17.2, R18.2, R19.2, U7.23 (AGND), U8.23 (AGND), U9.23 (AGND); also elsewhere on the board
unnamed: C21.1, R13.1, U7.12 (PGND), U7.13 (PGND), U7.14 (PGND), U7.15 (PGND)
unnamed: C26.1, R16.1, U8.12 (PGND), U8.13 (PGND), U8.14 (PGND), U8.15 (PGND)
unnamed: C30.1, R19.1, U9.12 (PGND), U9.13 (PGND), U9.14 (PGND), U9.15 (PGND)
unnamed: R12.1, U7.2 (DVS1)
unnamed: R11.1, U7.1 (DVS2)
unnamed: C19.1, U7.19 (VB)
unnamed: C18.2, U7.20 (VCC)
unnamed: C20.1, U7.6 (VTP)
unnamed: R15.1, U8.2 (DVS1)
unnamed: R14.1, U8.1 (DVS2)
unnamed: C24.1, U8.19 (VB)
unnamed: C23.2, U8.20 (VCC)
unnamed: C25.1, U8.6 (VTP)
unnamed: R18.1, U9.2 (DVS1)
unnamed: R17.1, U9.1 (DVS2)
unnamed: C28.1, U9.19 (VB)
unnamed: C27.2, U9.20 (VCC)
unnamed: C29.1, U9.6 (VTP)

Notes on the sheet:
NOTE: 20, VCC, Supply input for analog functions. Bypass VCC to AGND with a 0.1uF~10uF ceramic capacitor and as close to VCC pin as possible. (page 3)
NOTE: 12, 13, 14, 15 PGND Power ground. Reserved one 0603 X7R ceramic capacitor (0.1uF~1uF) between PGND and AGND is needed. (page 3)
NOTE: No idea if the inductor that is serial to VOUT is needed. May depend on specific motor used, check link!
AOZ9510QI
NOTE: Making a guess on R10 PGND to GND resistor. RL_ON VOUT-PGND RON VIN= 12V, LIN= 5V, PGND= 0, VOUT= 1A 6 mΩ (page 5)
NOTE: Assuming no difference between AGND V. PGND
NOTE: 1µF decoupling capacitor value is a GUESS!

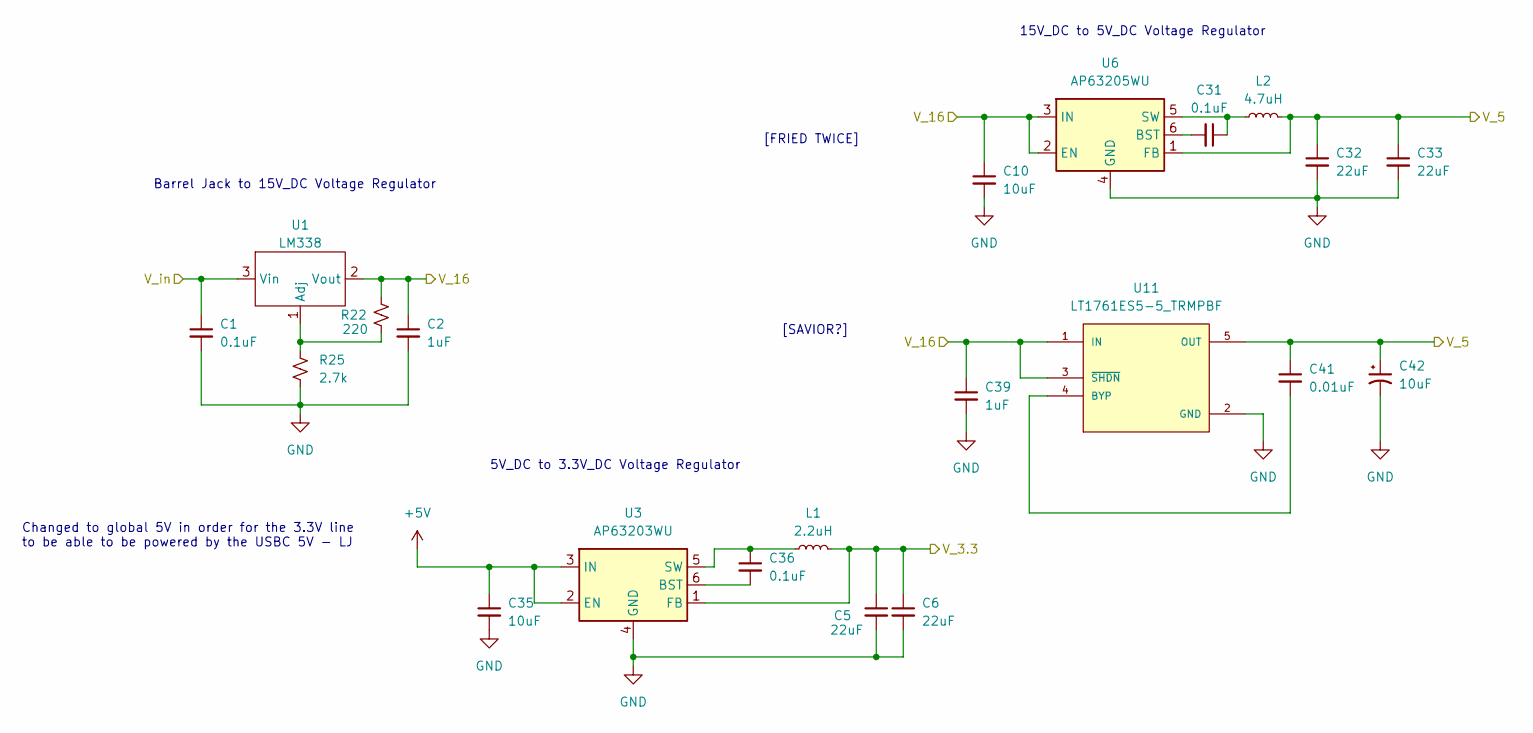
[picture p18: schematic voltage_regulators.kicad_sch]

Parts:
C1, C31, C36: 0.1uF; C_0805_2012Metric
C2, C39: 1uF; C_0805_2012Metric
C5, C6, C32, C33: 22uF; C_0805_2012Metric
C10, C35: 10uF; C_0805_2012Metric
C41: 0.01uF; C_0805_2012Metric
C42: 10uF; C_Radial_D8.0mm_H11.5mm_P3.50mm
L1: 2.2uH; L_1008_2520Metric
L2: 4.7uH; L_1210_3225Metric
R22: 220; R_0805_2012Metric
R25: 2.7k; R_0805_2012Metric
U1: LM338; TO-220-3
U3: AP63203WU; TSOT-23-6
U6: AP63205WU; TSOT-23-6
U11: LT1761ES5-5_TRMPBF; SOT95P280X100-5N; PARTREV F

Connections:
+3.3V: C5.1, C6.1, L1.2, U3.1 (FB); also elsewhere on the board
+5V: C35.1, U3.2 (EN), U3.3 (IN); also elsewhere on the board
+16V: C2.1, C10.1, C39.1, R22.1, U1.2 (Vout), U6.2 (EN), U6.3 (IN), U11.1 (IN), U11.3 (~SHDN); also elsewhere on the board
/Voltage Regulators/V_5: C32.1, C33.1, C41.1, C42.1, L2.2, U6.1 (FB), U11.5 (OUT); also elsewhere on the board
/Voltage Regulators/V_in: C1.1, U1.3 (Vin); also elsewhere on the board
GND: C1.2, C2.2, C5.2, C6.2, C10.2, C32.2, C33.2, C35.2, C39.2, C42.2, R25.2, U3.4 (GND), U6.4 (GND), U11.2 (GND); also elsewhere on the board
unnamed: R22.2, R25.1, U1.1 (Adj)
unnamed: C36.2, U3.6 (BST)
unnamed: C36.1, L1.1, U3.5 (SW)
unnamed: C31.2, U6.6 (BST)
unnamed: C31.1, L2.1, U6.5 (SW)
unnamed: C41.2, U11.4 (BYP)

Notes on the sheet:
Barrel Jack to 15V_DC Voltage Regulator
5V_DC to 3.3V_DC Voltage Regulator
[SAVIOR?]
Changed to global 5V in order for the 3.3V line to be able to be powered by the USBC 5V - LJ
15V_DC to 5V_DC Voltage Regulator
[FRIED TWICE]

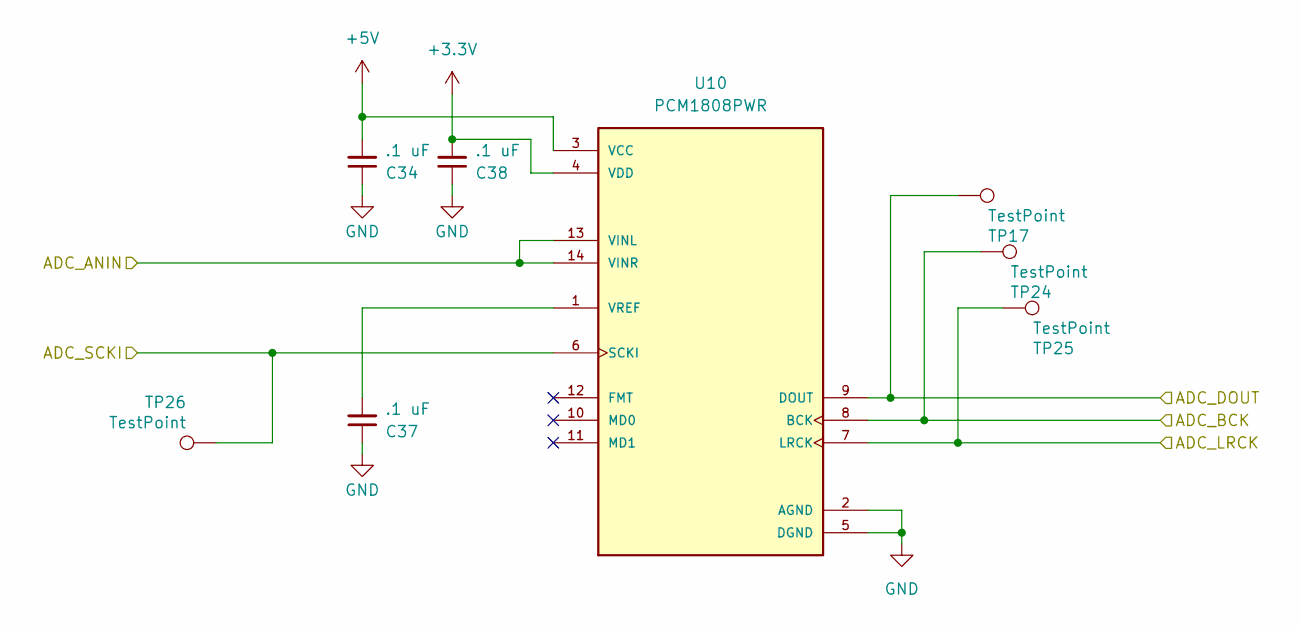
[picture p19: schematic ADC.kicad_sch]

Parts:
C34, C37, C38: .1 uF; C_0805_2012Metric
TP17, TP24, TP25, TP26: TestPoint; TestPoint_Pad_1.5x1.5mm
U10: PCM1808PWR; SOP65P640X120-14N; PARTREV B

Connections:
+3.3V: C38.2, U10.4 (VDD); also elsewhere on the board
+5V: C34.2, U10.3 (VCC); also elsewhere on the board
/ADC_ANIN: U10.13 (VINL), U10.14 (VINR); also elsewhere on the board
/ADC_BCK: TP24.1, U10.8 (BCK); also elsewhere on the board
/ADC_DOUT: TP17.1, U10.9 (DOUT); also elsewhere on the board
/ADC_LRCK: TP25.1, U10.7 (LRCK); also elsewhere on the board
/ADC_SCKI: TP26.1, U10.6 (SCKI); also elsewhere on the board
GND: C34.1, C37.1, C38.1, U10.2 (AGND), U10.5 (DGND); also elsewhere on the board
unnamed: C37.2, U10.1 (VREF)

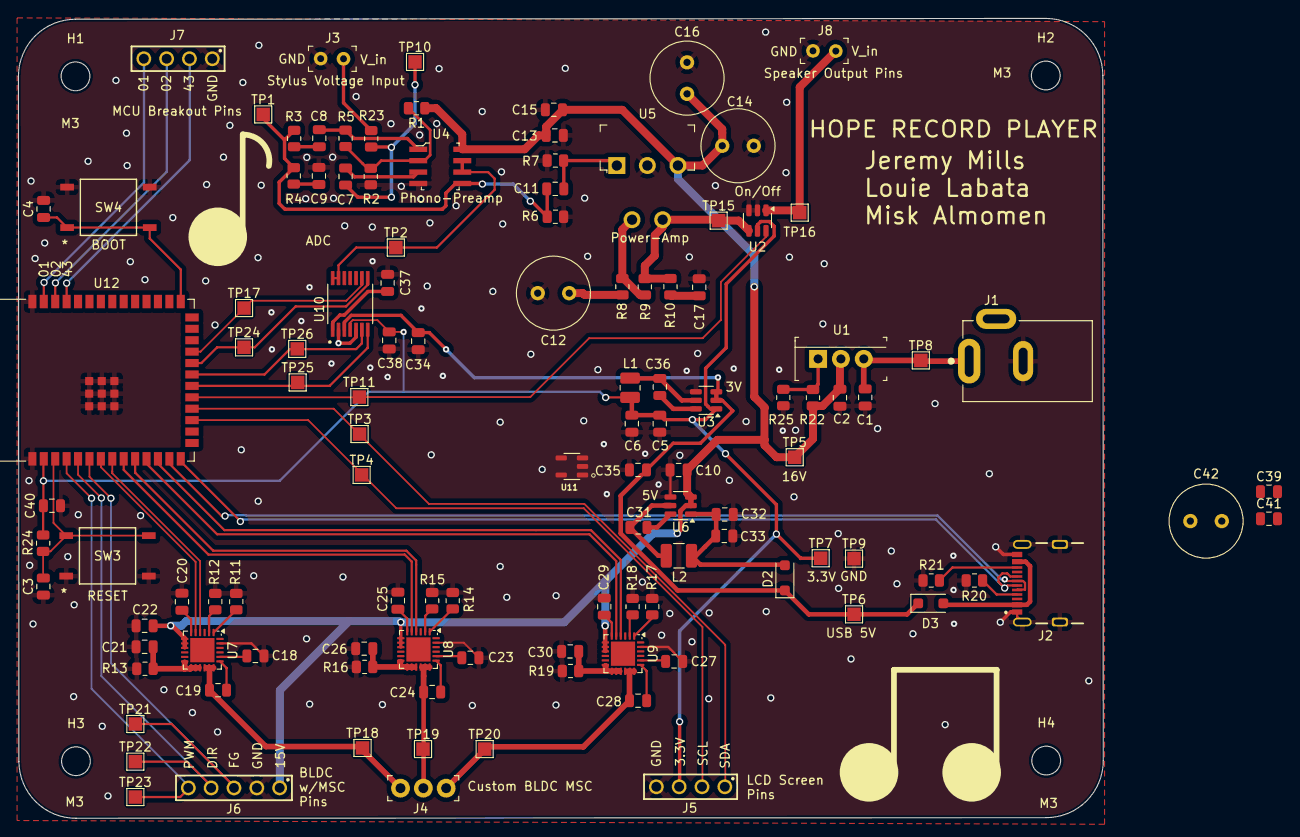
[picture p20: board hope_final_project.kicad_pcb from above]

Board: 2 copper layers, 120.7 x 89.0 mm, 120 parts (0 on the bottom side), 75 nets.
