Jeremy-Ryan-Mills/hope-project/(commit log)

2024-09-30 Created project
    [hope_final_project.kicad_pcb, hope_final_project.kicad_sch]
2024-10-01 Updated schematic for 230VAC to 15VAC regulator
    [15V_DC_Powersupply.kicad_sch]
2024-10-01 Completed 5V regulator and filled out values for both 15 and 5V regulators
2024-10-01 Commiting what I didn't save for last push
    [hope_final_project.kicad_sch]
2024-10-01 Worked on Phono Preamp circuit
    [hope_final_project.kicad_sch]
2024-10-02 Finished phono preamp and power amp, still subject to passive value changes
    [hope_final_project.kicad_sch]
2024-10-10 Started working on motor drivers and MCU
    [BLDC_motor_driver.kicad_sch, ESP32_S2_SOLO.kicad_sch, hope_final_project.kicad_sch]
2024-10-11 worked on audio amp and moved voltage regulators to a new sheet
    [BLDC_motor_driver.kicad_sch, audio_amp.kicad_sch, hope_final_project.kicad_sch, voltage_regulators.kicad_sch]
2024-10-16 Finished audio amplifier, added 3.3V regulator,etc
    [BLDC_motor_driver.kicad_sch, audio_amp.kicad_sch, hope_final_project.kicad_sch, voltage_regulators.kicad_sch]
2024-10-17 added usb c receptacle
    [BLDC_motor_driver.kicad_sch, audio_amp.kicad_sch, hope_final_project.kicad_sch, voltage_regulators.kicad_sch]
2024-10-18 Connected external DAC to MCU
    [hope_final_project.kicad_sch]
2024-10-18 ADC and DAC
    [audio_amp.kicad_sch, hope_final_project.kicad_sch, voltage_regulators.kicad_sch]
2024-10-19 Replaced 3.3V regulator
    [voltage_regulators.kicad_sch]
2024-10-19 Finishing touches for schematic turn in
    [BLDC_motor_driver.kicad_sch, audio_amp.kicad_sch, hope_final_project.kicad_sch, voltage_regulators.kicad_sch]
2024-10-19 Added BOM
2024-10-26 Added footprints that already exist in the library
    [BLDC_motor_driver.kicad_sch, audio_amp.kicad_sch, hope_final_project.kicad_sch, voltage_regulators.kicad_sch]
2024-10-26 Cleaning up footprint and starting layout
    [10118193-0001LF.step, AST-03208MR-R.step, BLDC_motor_driver.kicad_sch, PJ-002B.step, audio_amp.kicad_sch, hope_final_project.kicad_pcb, hope_final_project.kicad_sch, voltage_regulators.kicad_sch]
2024-10-27 worked on the layout
    [hope_final_project.kicad_pcb]
2024-10-27 Made some progress on the layout
    [hope_final_project.kicad_pcb, hope_final_project.kicad_sch]
2024-10-28 Working on layout and updated according to feedback from schematic
    [BLDC_motor_driver.kicad_sch, hope_final_project.kicad_pcb, hope_final_project.kicad_sch, voltage_regulators.kicad_sch]
2024-10-28 Worked on Layout, connected motor drivers
    [hope_final_project.kicad_pcb]
2024-10-28 no more DRC errors
    [BLDC_motor_driver.kicad_sch, audio_amp.kicad_sch, hope_final_project.kicad_sch, voltage_regulators.kicad_sch]
2024-10-28 updated Motor Controller layout and schematic a bit
    [BLDC_motor_driver.kicad_sch, hope_final_project.kicad_pcb, hope_final_project.kicad_sch]
2024-10-29 Work on headers and layout
    [BLDC_motor_driver.kicad_sch, audio_amp.kicad_sch, hope_final_project.kicad_pcb, hope_final_project.kicad_sch, voltage_regulators.kicad_sch]
2024-10-30 Fixed power
    [audio_amp.kicad_sch, hope_final_project.kicad_pcb, hope_final_project.kicad_sch, voltage_regulators.kicad_sch]
2024-10-30 Finished USB receptacle
    [audio_amp.kicad_sch, hope_final_project.kicad_pcb, hope_final_project.kicad_sch]
2024-10-30 Attempting to switch over to ESP32-S3
    [BLDC_motor_driver.kicad_sch, audio_amp.kicad_sch, hope_final_project.kicad_sch, voltage_regulators.kicad_sch]
2024-10-31 Beginning to add reset/boot buttons and power
    [hope_final_project.kicad_sch]
2024-10-31 Added switching IC
    [10118193-0001LF.step, BLDC_motor_driver.kicad_sch, USB4105GFA120.step, audio_amp.kicad_sch, hope_final_project.kicad_pcb, hope_final_project.kicad_sch, voltage_regulators.kicad_sch]
2024-10-31 thickened traces
    [hope_final_project.kicad_pcb]
2024-11-01 Wrapped up layout, increased trace width
    [hope_final_project.kicad_pcb, hope_final_project.kicad_sch]
2024-11-01 Made uniform vias
    [hope_final_project.kicad_pcb]
2024-11-02 Made it so the 3.3V line can be powered by the 5V of the USBC
    [BLDC_motor_driver.kicad_sch, audio_amp.kicad_sch, hope_final_project.kicad_sch, voltage_regulators.kicad_sch]
2024-11-02 added some power to S3 now in main
    [hope_final_project.kicad_sch]
2024-11-02 added s3 footprint and finished adding s3 to schematic
    [hope_final_project.kicad_sch]
2024-11-02 Cleaned up S3 schematic DRC errors
    [hope_final_project.kicad_sch]
2024-11-02 Finished changes. submitting layout review
    [hope_final_project.kicad_pcb, hope_final_project.kicad_sch]
2024-11-02 final touches I forgot
    [hope_final_project.kicad_pcb, hope_final_project.kicad_sch]
2024-11-05 Updated schematic to include a LCD screen connector and added another connector for a BLDC motor w/built-in encoder
    [BLDC_motor_driver.kicad_sch, hope_final_project.kicad_sch]
2024-11-05 added new components to layout from schematic update
    [hope_final_project.kicad_sch]
2024-11-05 More layout changes
    [hope_final_project.kicad_pcb]
2024-11-05 Implemented schematic changes to layout (added screen and new MCU), implemented some feedback
    [BLDC_motor_driver.kicad_sch, hope_final_project.kicad_pcb, hope_final_project.kicad_sch, voltage_regulators.kicad_sch]
2024-11-06 Added changes including unity gain buffer
    [BLDC_motor_driver.kicad_sch, audio_amp.kicad_sch, hope_final_project.kicad_pcb, hope_final_project.kicad_sch]
2024-11-07 House Keeping
    [BLDC_motor_driver.kicad_sch, audio_amp.kicad_sch, hope_final_project.kicad_sch, voltage_regulators.kicad_sch]
2024-11-07 Fixed power amplifier and voltage regulator situation
    [audio_amp.kicad_sch, hope_final_project.kicad_pcb, voltage_regulators.kicad_sch]
2024-11-07 decoupling capacitors
    [hope_final_project.kicad_pcb]
2024-11-08 Adjusting layout
    [audio_amp.kicad_sch, hope_final_project.kicad_pcb, hope_final_project.kicad_sch, voltage_regulators.kicad_sch]
2024-11-08 16V adjustments
    [audio_amp.kicad_sch, hope_final_project.kicad_sch]
2024-11-08 Changed the footprint and schematic of the J5 J7 connectors to match BOM
    [6130XX11121_61300411121.step, BLDC_motor_driver.kicad_sch, audio_amp.kicad_sch, hope_final_project.kicad_pcb, hope_final_project.kicad_sch, voltage_regulators.kicad_sch]
2024-11-08 Changed another connector to fit BOM
    [6130XX11121_61300511121.step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]
2024-11-08 Final submission
    [hope_final_project-B_Cu.gbl, hope_final_project-B_Mask.gbs, hope_final_project-B_Paste.gbp, hope_final_project-B_Silkscreen.gbo, hope_final_project-Edge_Cuts.gm1, hope_final_project-F_Cu.gtl, hope_final_project-F_Mask.gts, hope_final_project-F_Paste.gtp]
2024-11-08 Fixing last minute DRC errors
    [hope_final_project-B_Cu.gbl, hope_final_project-B_Mask.gbs, hope_final_project-B_Paste.gbp, hope_final_project-B_Silkscreen.gbo, hope_final_project-Edge_Cuts.gm1, hope_final_project-F_Cu.gtl, hope_final_project-F_Mask.gts, hope_final_project-F_Paste.gtp]
2024-11-08 FINAL FINAL submission
    [ADC.kicad_sch, PCM1808PWR.step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]
2024-12-07 Maybe could replace 5V buck with something else?
    [LT1761ES5-5_TRMPBF.step, hope_final_project.kicad_pcb, hope_final_project.kicad_sch, voltage_regulators.kicad_sch]
